lorenzpammer/olfStim/Documentation/LASOMMaterial/LASOM1/Doc/LASOM_Connectors2.jpg

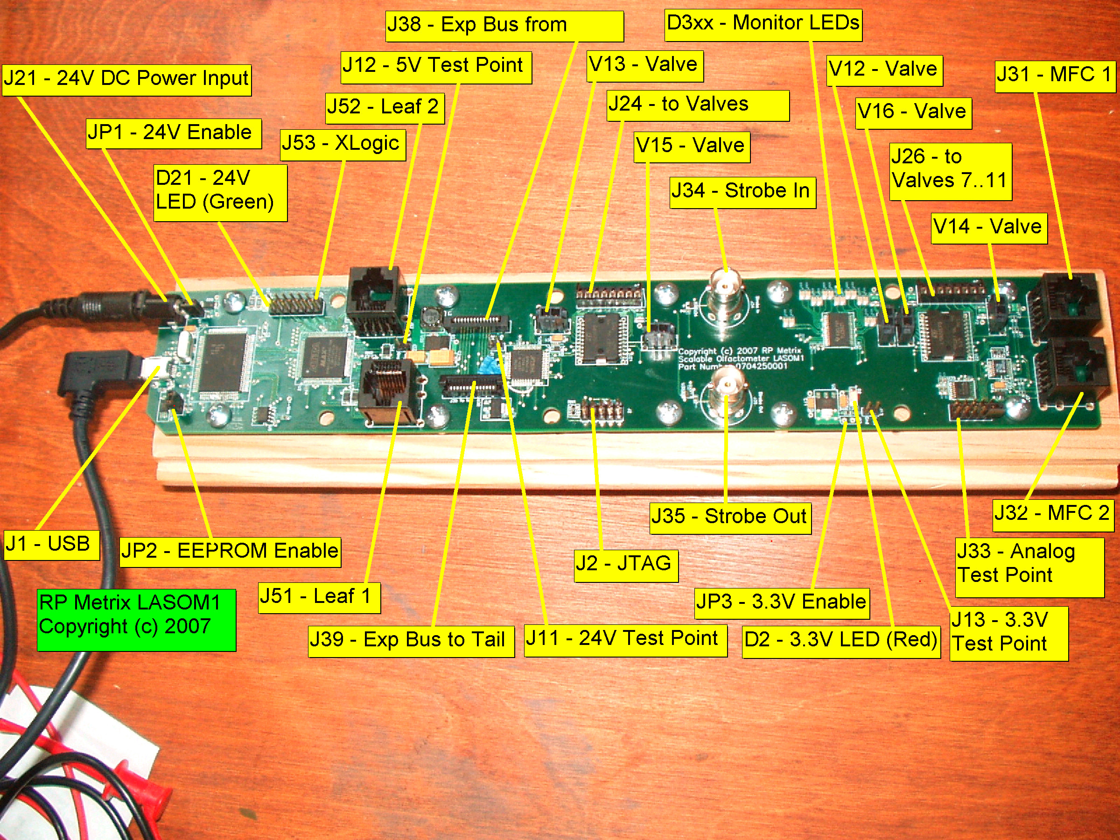
Documentation/LASOMMaterial/LASOM1/Doc/LASOM_Connectors2.jpg
