lorenzpammer/olfStim/Documentation/Hardware Parts/OdorantVials.jpg

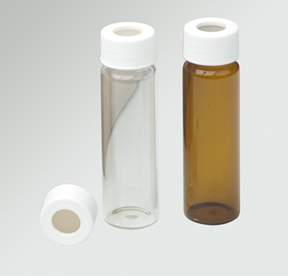
Documentation/Hardware Parts/OdorantVials.jpg
