lorenzpammer/olfStim/README.md

olfStim
=======
olfStim is a collection of functions to control an olfactometer from a gui.
It works but is still very much geared towards use in our lab.
