lorenzpammer/olfStim/Documentation/systemArchitecture.pdf

Master Computer

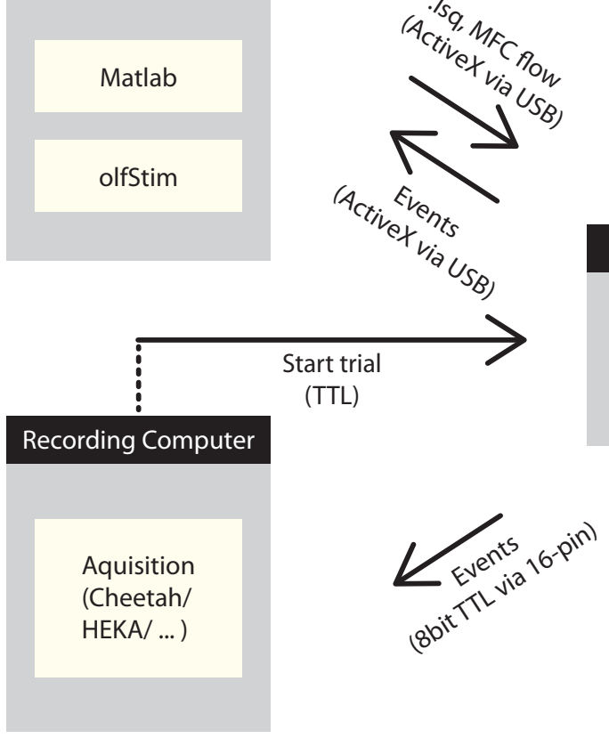
[picture p3: figure]
olfStim; Recording Computer; Aquisition (Cheetah/ HEKA/ ... ); Start trial (TTL); (ActiveX via USB); Events; (8bit TTL via 16-pin); (ActiveX via USB) Events

Matlab

2 MFCs

LASOM C1

LASOM

LASOM V1

Opening/closing
(20 pin connector)

.lsq, MFC ow

≤ 32 valves

Flow rates, etc.
(RS232 via RJ45)
Hardware | Software | Computer

Data ow
(Connector)

Legend

Flow rates, etc.
(RS232 via RJ45)
