lorenzpammer/olfStim/Documentation/Olfactometer_Schematic.jpg

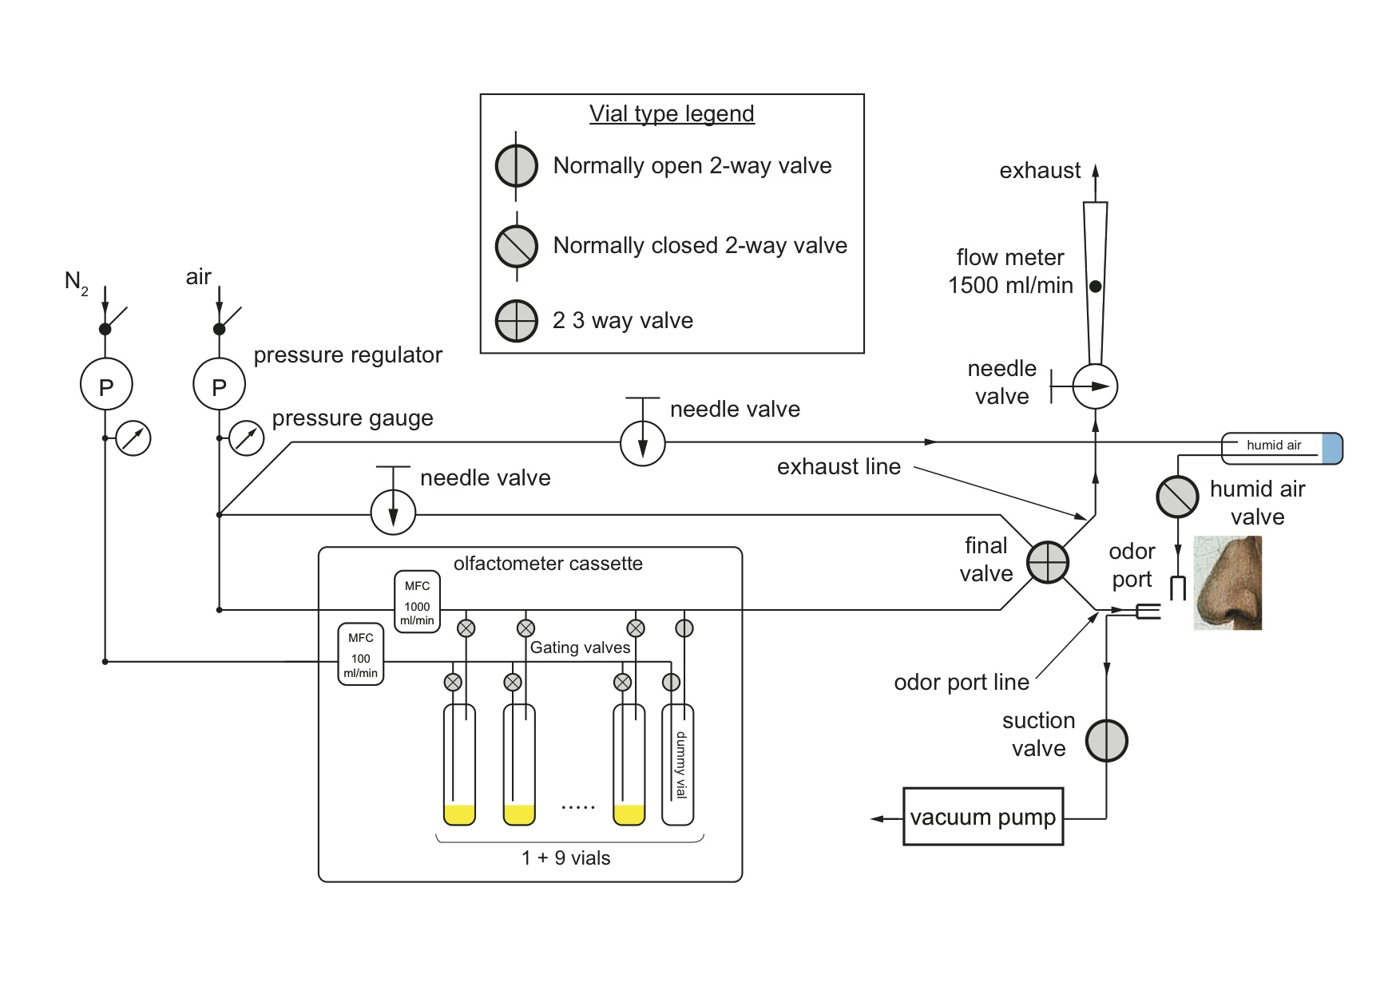
Documentation/Olfactometer_Schematic.jpg
