lorenzpammer/olfStim/Documentation/LASOMMaterial/LASOM2_1102250002/Doc/LASOM2_V1.pdf

LASOM2 Valve Driver Module | LASOM2.V1

## Valve Driver Module for a

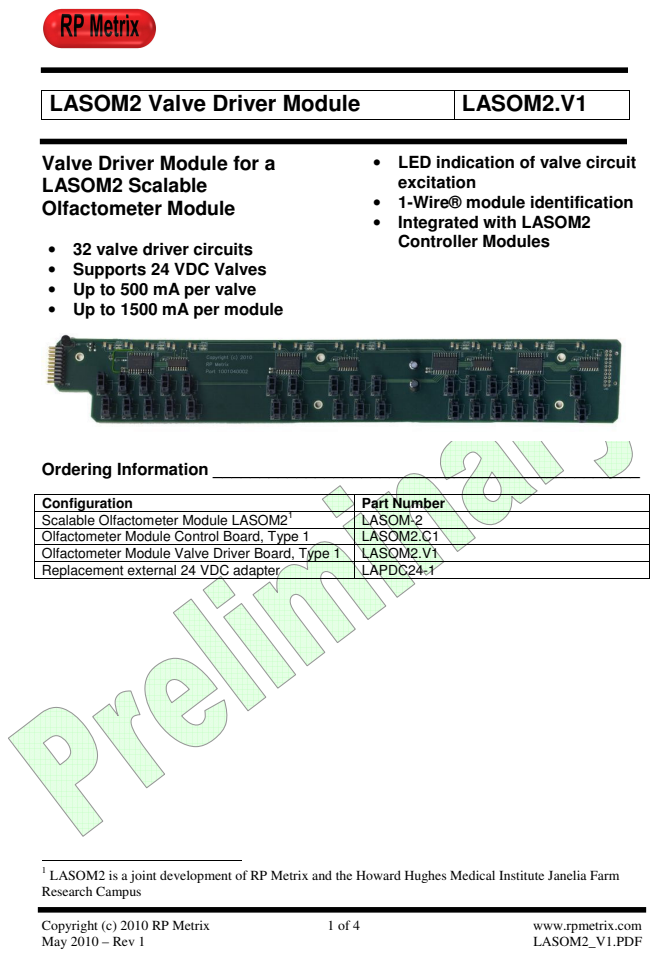
[picture p18: page 1]
Copyright (c) 2010 RP Metrix; www.rpmetrix.com; May 2010 – Rev 1; LASOM2_V1.PDF; LASOM2 Scalable Olfactometer Module; Ordering Information ______________________________________________

• LED indication of valve circuit
excitation
• 1-Wire® module identification
• Integrated with LASOM2
Controller Modules

• 32 valve driver circuits
• Supports 24 VDC Valves
• Up to 500 mA per valve
• Up to 1500 mA per module

Configuration | Part Number
Scalable Olfactometer Module LASOM2¹ | LASOM-2
Olfactometer Module Control Board, Type 1 | LASOM2.C1
Olfactometer Module Valve Driver Board, Type 1 | LASOM2.V1
Replacement external 24 VDC adapter | LAPDC24-1

LASOM2 is a joint development of RP Metrix and the Howard Hughes Medical Institute Janelia Farm
Research Campus

## RP Metrix ____________________________ LASOM2.V1

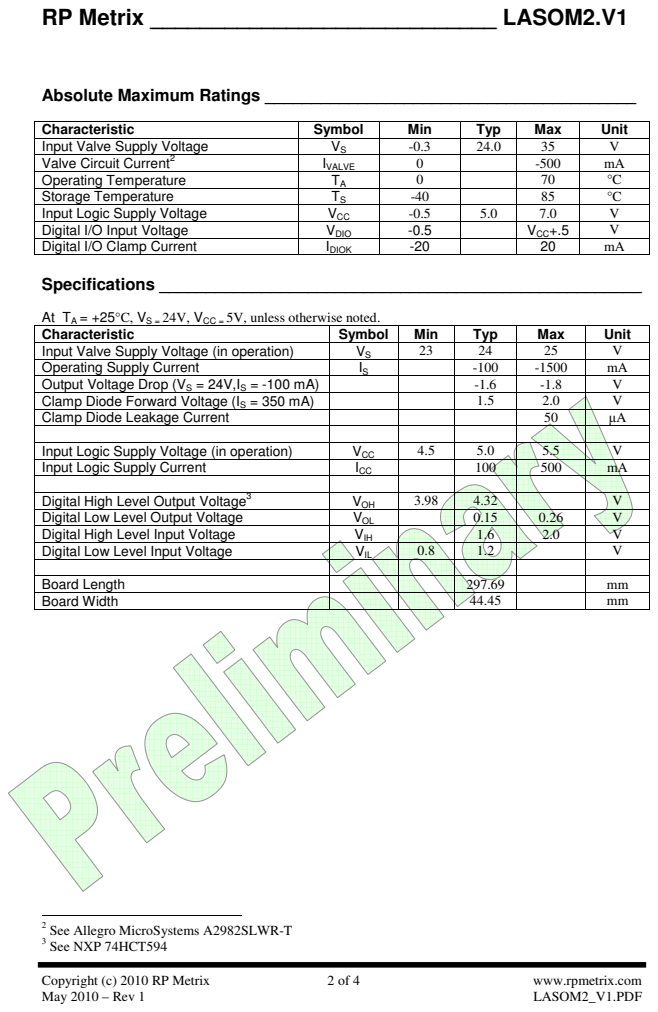
[picture p19: page 2]
Copyright (c) 2010 RP Metrix; www.rpmetrix.com; Specifications ____________________________________________________; See Allegro MicroSystems A2982SLWR-T; See NXP 74HCT594

Absolute Maximum Ratings ________________________________________

Characteristic | Symbol | Min | Typ | Max | Unit
Input Valve Supply Voltage | VS | -0.3 | 24.0 | 35 | V
Valve Circuit Current² | IVALVE | 0 | | -500 | mA
Operating Temperature | TA | 0 | | 70 | °C
Storage Temperature | TS | -40 | | 85 | °C
Input Logic Supply Voltage | VCC | -0.5 | 5.0 | 7.0 | V
Digital I/O Input Voltage | VDIO | -0.5 | | VCC+.5 | V
Digital I/O Clamp Current | IDIOK | -20 | | 20 | mA

At TA = +25°C, VS = 24V, VCC = 5V, unless otherwise noted.

Input Valve Supply Voltage (in operation) | VS | 23 | 24 | 25 | V
Operating Supply Current | IS | | -100 | -1500 | mA
Output Voltage Drop (VS = 24V,IS = -100 mA) | | | -1.6 | -1.8 | V
Clamp Diode Forward Voltage (IS = 350 mA) | | | 1.5 | 2.0 | V
Clamp Diode Leakage Current | | | | 50 | µA

Input Logic Supply Voltage (in operation) | VCC | 4.5 | 5.0 | 5.5 | V
Input Logic Supply Current | ICC | | 100 | 500 | mA

Digital High Level Output Voltage³ | VOH | 3.98 | 4.32 | | V
Digital Low Level Output Voltage | VOL | | 0.15 | 0.26 | V
Digital High Level Input Voltage | VIH | | 1.6 | 2.0 | V
Digital Low Level Input Voltage | VIL | 0.8 | 1.2 | | V

Board Length | 297.69 | mm
Board Width | 44.45 | mm

Copyright (c) 2010 RP Metrix | 3 of 4 | www.rpmetrix.com

### Description ______________________________________________________

The LASOM2 Scalable Olfactometer Module is a plug mount module that connects to clean gas sources and delivers an odorized gas flow to an olfaction experiment. See the LASOM2.C1 datasheet for a more detailed description.

The LASOM2.V1 Valve Driver Module converts logic level control signals into valve excitation signals for up to 32 valves using 24 VDC drive coils. A LASOM2.Cx Controller Module prepares the control signals and directs the valve driver module to energize the valves.

The core logic components on the Valve Driver Module comprise a daisy chain of four 74HCT594 8-bit shift registers. The Controller Module shifts a 32-bit word of excitation signals into the register chain, and then copies the result into the 74HCT594 output registers.

Each of the 32 register output logic signals drives a monitor LED (D401..D432) and energizes a high-side 24VDC valve driver. The drivers are internally protected from short circuits and thermal overload. The per-valve current capacity of 500 mA is far above the typical 10 to 20 mA requirement of odor selection valve coils.

The LASOM2.V1 Driver Module is intended to support an olfactometer servicing 10 to 14 odor vials, with 2 valve circuits used per vial. One extra vial is typically operated with normally open valves to support a background gas flow comparable to the flow occurring when an actual odor is selected. This implies that up to 15 vials and 30 valve circuits are committed to odor selection, with 2 valve circuits unassigned. Controller Module firmware manages these conventions for valve circuit activation – the Valve Driver itself merely carries out instructions to energize an arbitrary combination of 32 valve circuits.

The previous 32-bit control word is normally looped back to the Controller via resistor R40. The J40 expansion port may be used to extend the valve driver to additional valves. (Appropriate controller firmware modifications are also required.)

The on board 1-Wire Identifier chip electronically serializes the Driver Module so that the set of odor vials coupled to the board can be tracked in managed between experiments.

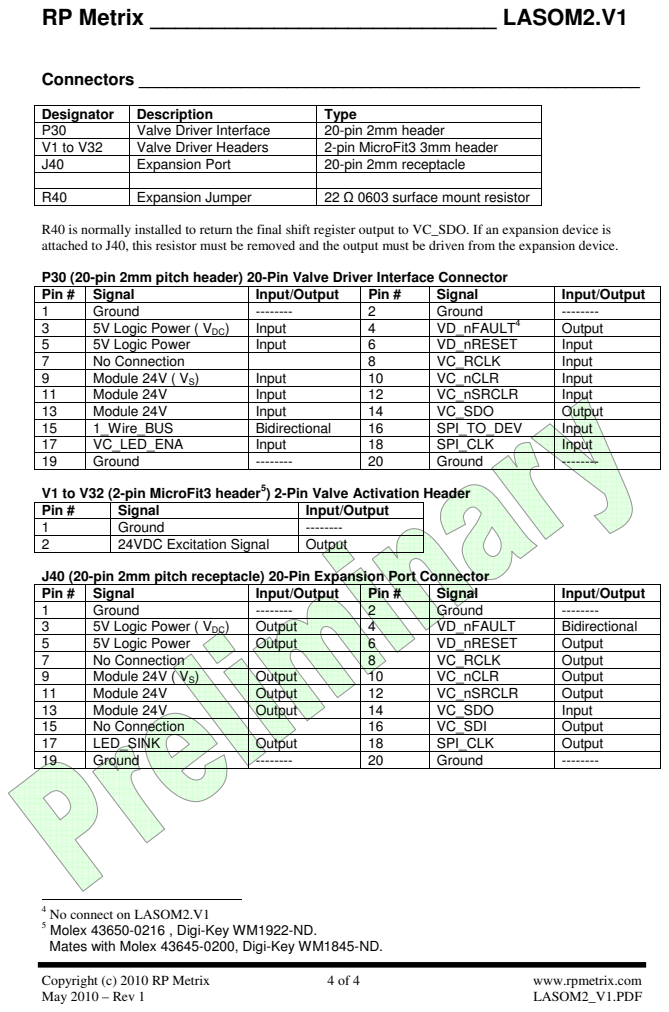
[picture p20: page 4]
Copyright (c) 2010 RP Metrix; www.rpmetrix.com; Connectors ______________________________________________________; Expansion Jumper; 22 Ω 0603 surface mount resistor

Designator | Description | Type
P30 | Valve Driver Interface | 20-pin 2mm header
V1 to V32 | Valve Driver Headers | 2-pin MicroFit3 3mm header
J40 | Expansion Port | 20-pin 2mm receptacle

R40 is normally installed to return the final shift register output to VC_SDO. If an expansion device is
attached to J40, this resistor must be removed and the output must be driven from the expansion device.

P30 (20-pin 2mm pitch header) 20-Pin Valve Driver Interface Connector

Pin # | Signal | Input/Output | Pin # | Signal | Input/Output
1 | Ground | -------- | 2 | Ground | --------
3 | 5V Logic Power ( VDC) | Input | 4 | VD_nFAULT⁴ | Output
5 | 5V Logic Power | Input | 6 | VD_nRESET | Input
7 | No Connection | | 8 | VC_RCLK | Input
9 | Module 24V ( VS) | Input | 10 | VC_nCLR | Input
11 | Module 24V | Input | 12 | VC_nSRCLR | Input
13 | Module 24V | Input | 14 | VC_SDO | Output
15 | 1_Wire_BUS | Bidirectional | 16 | SPI_TO_DEV | Input
17 | VC_LED_ENA | Input | 18 | SPI_CLK | Input
19 | Ground | -------- | 20 | Ground | --------

V1 to V32 (2-pin MicroFit3 header⁵

) 2-Pin Valve Activation Header

Pin # | Signal | Input/Output
1 | Ground | --------
2 | 24VDC Excitation Signal | Output

J40 (20-pin 2mm pitch receptacle) 20-Pin Expansion Port Connector

3 | 5V Logic Power ( VDC) | Output | 4 | VD_nFAULT | Bidirectional
5 | 5V Logic Power | Output | 6 | VD_nRESET | Output
7 | No Connection | | 8 | VC_RCLK | Output
9 | Module 24V ( VS) | Output | 10 | VC_nCLR | Output
11 | Module 24V | Output | 12 | VC_nSRCLR | Output
13 | Module 24V | Output | 14 | VC_SDO | Input
15 | No Connection | | 16 | VC_SDI | Output
17 | LED_SINK | Output | 18 | SPI_CLK | Output

No connect on LASOM2.V1
Molex 43650-0216 , Digi-Key WM1922-ND.
Mates with Molex 43645-0200, Digi-Key WM1845-ND.
