lorenzpammer/olfStim/Documentation/Hardware Parts/Ordering Info/Olfactometer Parts.xls

Vendor | Part Number | Description | Quantity | Units | Price each | Price | Currency | Comment
Nresearch | TBGM109 | Teflon Tubing OD 1/16, ID 1/32 | 30.00 | ft | 1.49 | 44.70 | $
Nresearch | TBGM108 | Teflon Tubing OD 0.105, ID 1/16 | 20.00 | ft | 1.49 | 29.80 | $
Nresearch | TBGM103 | Silicone Tubing, OD 1/4, ID 1/8 | 10.00 | ft | 3.10 | 31.00 | $
Nresearch | 252P109-50 | Two Piece Fitting Sets 1/4-28 | 1.00 | ea | 161.68 | 161.68 | $ | Fittings for OD 1/16 tubing
Nresearch | 253P108-50 | Three Piece Fitting Sets 1/4-28 | 1.00 | ea | 202.24 | 202.24 | $ | Fittings for OD 0.105 tubing
Nresearch | FITM128 | Plug 1/4-28 | 10.00 | ea | 1.56 | 15.60 | $
Nresearch | FITM131 | 1/4-28 Connectors Straight Teflon | 5.00 | ea | 10.88 | 54.40 | $
Nresearch | FITM132 | 1/4-28 Connectors Elbow Teflon | 3.00 | ea | 10.88 | 32.64 | $
Nresearch | FITM133 | 1/4-28 Connectors Tee Teflon | 5.00 | ea | 13.50 | 67.50 | $
Nresearch | FITM331 | Barb Fitting Zero Dead Volume (1/4-28, 1/16) | 5.00 | ea | 2.42 | 12.10 | $
Nresearch | FITM087 | Standard Barb Fittings, 1/8NPT, 1/16 | 6.00 | ea | 0.50 | 3.00 | $
Nresearch | FITM089 | Standard Barb Fittings, 1/8NPT, 1/8 | 4.00 | ea | 0.50 | 2.00 | $
Nresearch | MCRM360 | Mounting Rings for 360 valves | 4.00 | ea | 11.46 | 45.84 | $
Nresearch | SH360T042 | Dual 3-way isolation valve, 4 ports, 24V | 1.00 | ea | 162.69 | 162.69 | $
Nresearch | 360T012 | Standard 2-way normally closed valve, 2mm orifice, teflon-teflon, 24 V | 3 | ea | 112.53 | 337.59 | $
Nresearch | 360T022 | Standard 2-way Normally Open, 3mm orifice, teflon-teflon, 24 V | 1.00 | ea | 110.93 | 110.93 | $
Nresearch | 161T102HH | Inline 5x2 way (1NO-4NC, 24V) | 2.00 | ea | 323.31 | 646.62 | $
Nresearch | 161T102 | Inline 5x2 way Normally closed, 24V | 2.00 | ea | 323.31 | 646.62 | $
Omnifit (via Novodirect) | 24600 | Omnifit small 2-way straight connector 1.5 mm | 2 | ea | 53.00 € | 106.00 | €
Omnifit (via Novodirect) | 24400 | Omnifit small 2-way straight connector 0.8 mm | 3 | ea | 60.80 € | 182.40 | €
Omnifit (via Novodirect) | 24750 | Omnifit small 2-way L-connector 1.5 mm | 1 | ea | 60.50 € | 60.50 | €
Omnifit (via Novodirect) | 24606 | Omnifit small 3-way T connector 1.5 mm | 3 | ea | 57.70 € | 173.10 | €
Omnifit (via Novodirect) | 24607 | Omnifit large to small connector 1.5 mm diam | 1 | ea | 73.10 € | 73.10 | €
Omnifit (via Novodirect) | 24608 | Omnifit large 2 way connector 4.5 mm diam | 1 | ea | 86.20 € | 86.20 | €
Omnifit (via Novodirect) | 24672 | Omnifit O-Ring 0.5-4 mm for small OD | 2 | ea | 6.30 € | 12.60 | €
Omnifit (via Novodirect) | 24673 | Omnifit O-Ring 0.5-4 mm for large OD | 2 | ea | 6.30 € | 12.60 | €
Omnifit (via Novodirect) | 24641 | Omnifit PTFE cone 3 mm | 1 | ea | 14.50 € | 14.50 | €
Omnifit (via Novodirect) | 24639 | Omnifit PTFE cone 2 mm | 1 | ea | 14.50 € | 14.50 | €
Omnifit (via Novodirect) | 24632 | Omnifit PTFE cone1/16" | 1 | ea | 14.50 € | 14.50 | €
Aalborg (via Novodirect) | W728AC | Aalborg Needle Valve PTFE 1/8NPT HighRes | 2.00 | ea | 164.00 | 328.00 | €
Aalborg (via Novodirect) | W73344 | Aalborg Flow Meter tube Air 23l/min 15cm | 1.00 | ea | 95.00 | 95.00 | €
