lorenzpammer/olfStim/Documentation/Hardware Parts/ColumnClamp.jpg

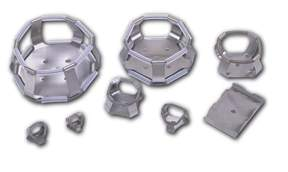
Documentation/Hardware Parts/ColumnClamp.jpg
