lorenzpammer/olfStim/Documentation/Hardware Parts/GasFilterColumn.jpg

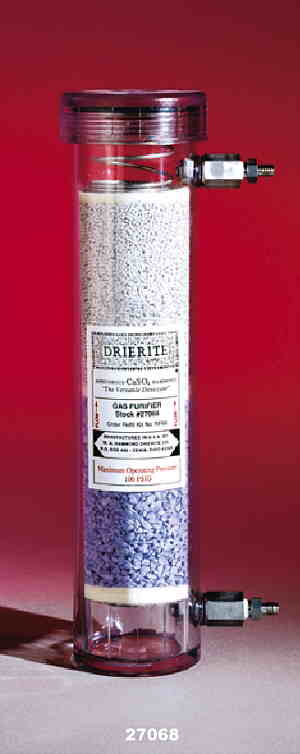
Documentation/Hardware Parts/GasFilterColumn.jpg
