lorenzpammer/olfStim/Documentation/Hardware Parts/Custom Machining/3D Printing Valve Holders/V1/HolderNResearch648Series.SLDPRT

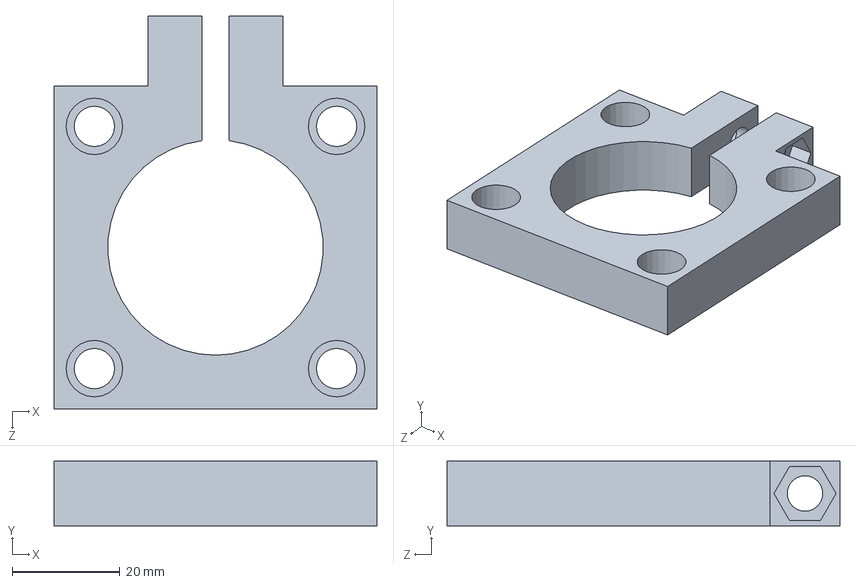
[picture p24: CAD file, 2015-01-07]
Documentation/Hardware Parts/Custom Machining/3D Printing Valve Holders/V1/HolderNResearch648Series.SLDPRT
60.0 x 12.0 x 73.0 mm
