lorenzpammer/olfStim/Documentation/Hardware Parts/Custom Machining/3d Printing Vial Holders/Holder_OdorVialsV3.SLDPRT

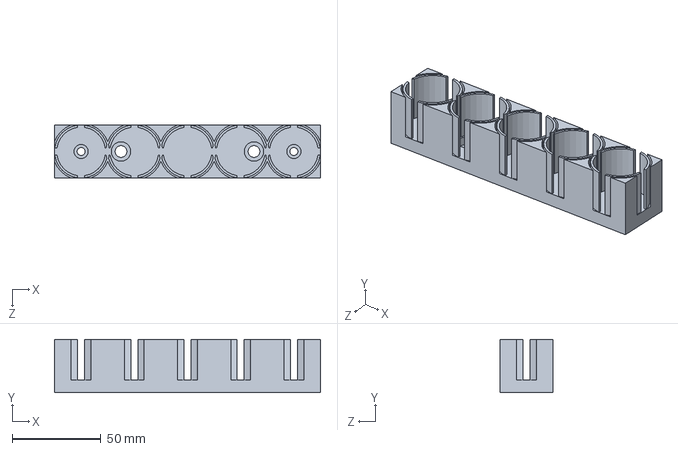
[picture p25: CAD file, 2015-01-07]
Documentation/Hardware Parts/Custom Machining/3d Printing Vial Holders/Holder_OdorVialsV3.SLDPRT
150.0 x 30.0 x 30.0 mm
