lorenzpammer/olfStim/Documentation/Hardware Parts/Custom Machining/3d Printing Vial Holders/v2/Holder_OdorVialsV2.SLDPRT

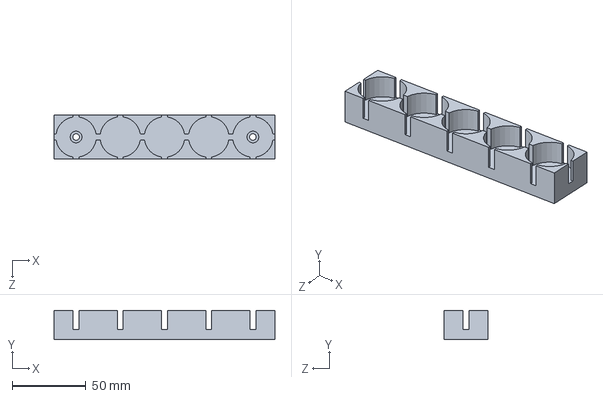
[picture p26: CAD file, 2015-01-07]
Documentation/Hardware Parts/Custom Machining/3d Printing Vial Holders/v2/Holder_OdorVialsV2.SLDPRT
150.0 x 20.0 x 30.0 mm
