lorenzpammer/olfStim/Documentation/Hardware Parts/Custom Machining/3D Printing Valve Holders/HolderNResearch648Seriesv2.SLDPRT

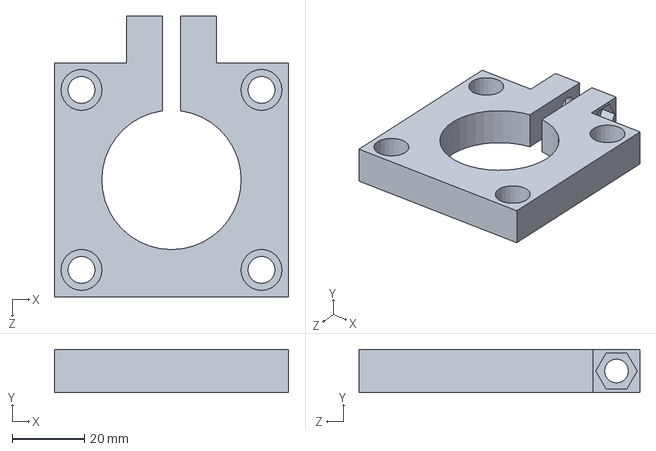
[picture p27: CAD file, 2015-01-07]
Documentation/Hardware Parts/Custom Machining/3D Printing Valve Holders/HolderNResearch648Seriesv2.SLDPRT
65.0 x 12.0 x 78.0 mm
