lorenzpammer/olfStim/Documentation/Hardware Parts/Custom Machining/3d Printing Vial Holders/Holder_OdorVialsV3_3Vials.SLDPRT

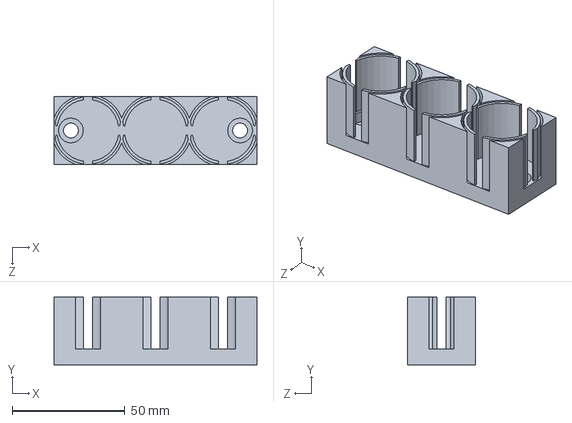
[picture p28: CAD file, 2015-01-07]
Documentation/Hardware Parts/Custom Machining/3d Printing Vial Holders/Holder_OdorVialsV3_3Vials.SLDPRT
90.0 x 30.0 x 30.0 mm
