lorenzpammer/olfStim/Documentation/Hardware Parts/Custom Machining/3D Printing Valve Holders/V1/HolderNResearch225Series.STL

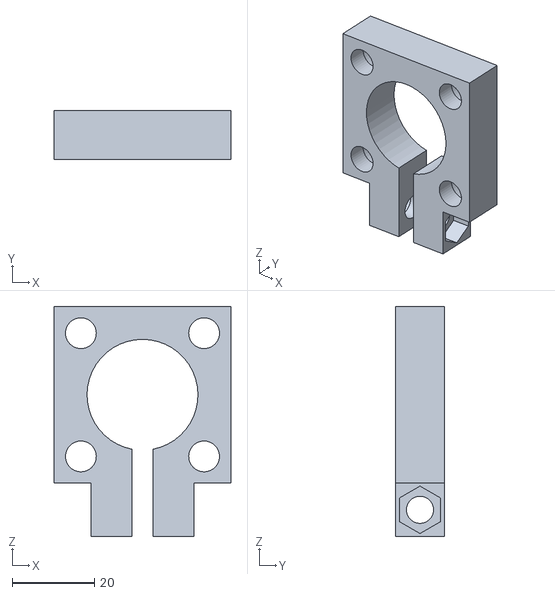
[picture p29: CAD file, 2015-01-07]
Documentation/Hardware Parts/Custom Machining/3D Printing Valve Holders/V1/HolderNResearch225Series.STL
43.0 x 12.0 x 56.0
