lorenzpammer/olfStim/Documentation/Hardware Parts/Custom Machining/3d Printing Vial Holders/v1/Holder_OdorVials.SLDPRT

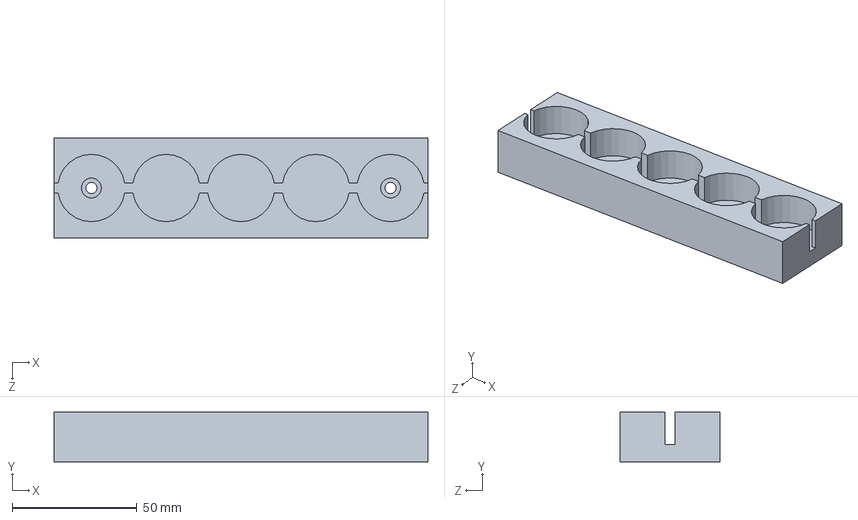
[picture p30: CAD file, 2015-01-07, an earlier design]
Documentation/Hardware Parts/Custom Machining/3d Printing Vial Holders/v1/Holder_OdorVials.SLDPRT
150.0 x 20.0 x 40.0 mm
