lorenzpammer/olfStim/(list of files, cad)

Other CAD files:
Documentation/Hardware Parts/Custom Machining/3D Printing Valve Holders/V1/HolderNResearch360Series.STL
Documentation/Hardware Parts/Custom Machining/3D Printing Valve Holders/HolderNResearch225Seriesv2.SLDPRT
Documentation/Hardware Parts/Custom Machining/3D Printing Valve Holders/HolderNResearch225Seriesv2.STL
Documentation/Hardware Parts/Custom Machining/3D Printing Valve Holders/HolderNResearch360Seriesv2.STL
Documentation/Hardware Parts/Custom Machining/3D Printing Valve Holders/HolderNResearch648Seriesv2.STL
Documentation/Hardware Parts/Custom Machining/3d Printing Vial Holders/Holder_OdorVialsV3.STL
Documentation/Hardware Parts/Custom Machining/3d Printing Vial Holders/Holder_OdorVialsV3_3Vials.STL
Documentation/Hardware Parts/Custom Machining/3d Printing Vial Holders/v1/Holder_OdorVials.SLDDRW
Documentation/Hardware Parts/Custom Machining/3d Printing Vial Holders/v1/Holder_OdorVials.STL
Documentation/Hardware Parts/Custom Machining/3d Printing Vial Holders/v2/Holder_OdorVialsV2.STL
