lorenzpammer/olfStim/Documentation/LASOMMaterial/LASOM1/Doc/Leaf_Wiring.pdf

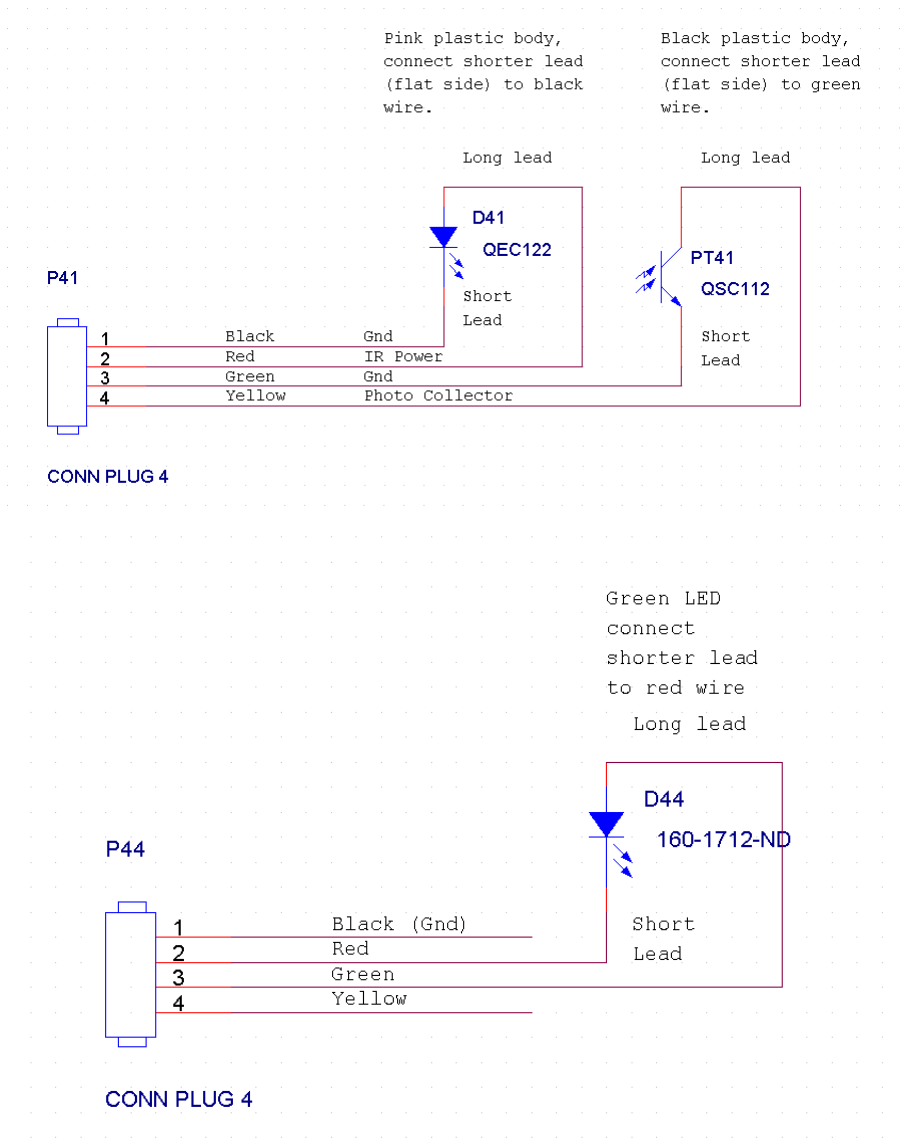
[picture p31: figure]
