lorenzpammer/olfStim/Documentation/Olfactometer_Schematic_General.pdf

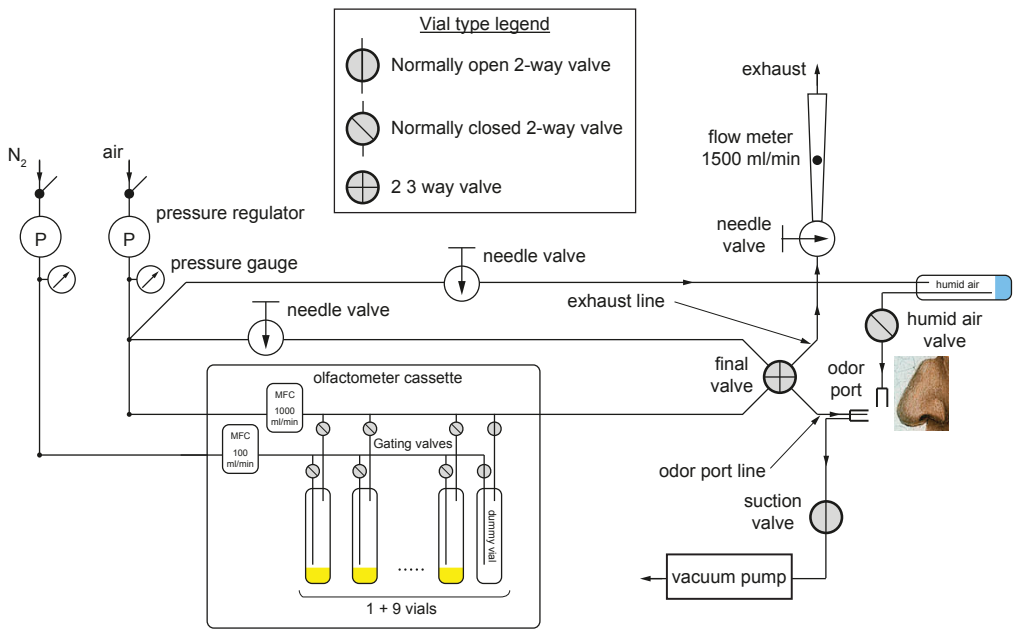
[picture p32: page 1]
air; final valve; exhaust; odor port; flow meter 1500 ml/min; pressure regulator; pressure gauge; needle valve; exhaust line; MFC 100 ml/min; MFC 1000 ml/min; 1 + 9 vials; olfactometer cassette; dummy vial; Gating valves; suction valve; humid air humid air valve; needle; vacuum pump; 2 3 way valve

Vial type legend
Normally open 2-way valve

Normally closed 2-way valve

valve needle valve

odor port line
