lorenzpammer/olfStim/Documentation/Olfactometer_Schematic_LaurentLab.pdf

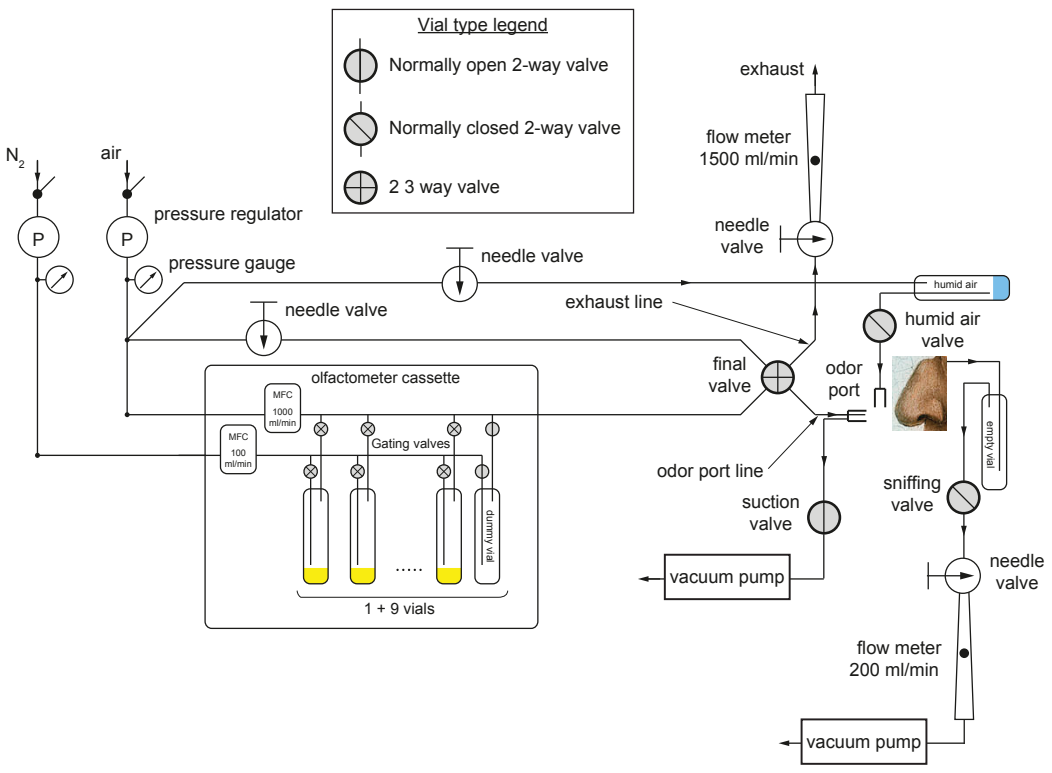
[picture p33: page 1]
air; final valve; exhaust; odor port; flow meter 1500 ml/min; pressure regulator; pressure gauge; needle valve; exhaust line; MFC 100 ml/min; MFC 1000 ml/min; 1 + 9 vials; olfactometer cassette; dummy vial; Gating valves; suction valve; humid air humid air valve; sniffing valve; flow meter 200 ml/min; vacuum pump; needle; 2 3 way valve; empty vial

Vial type legend
Normally open 2-way valve

Normally closed 2-way valve

valve needle valve

odor port line
