lorenzpammer/olfStim/Documentation/OlfactometerCassette.pdf

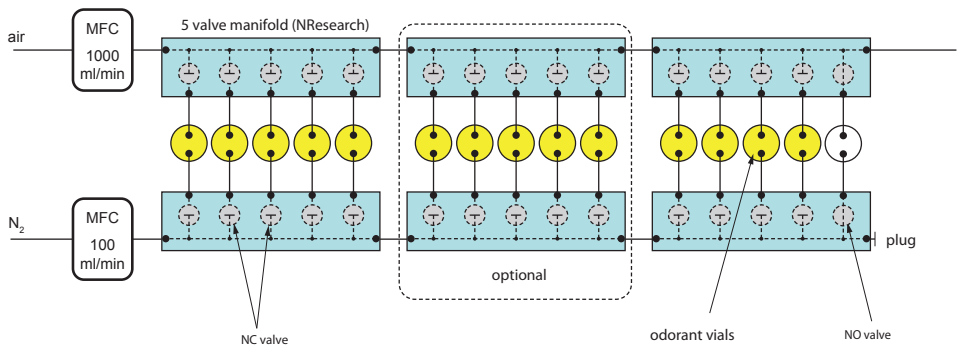
[picture p34: page 1]
air; MFC 1000 ml/min; MFC 100 ml/min; optional; odorant vials; plug

5 valve manifold (NResearch)

NO valve NC valve
