lorenzpammer/olfStim/Documentation/Hardware Parts/Custom Machining/AluminumBlockForMFCIQFlow.pdf

## UNF 10- 32 UNF 10- 32

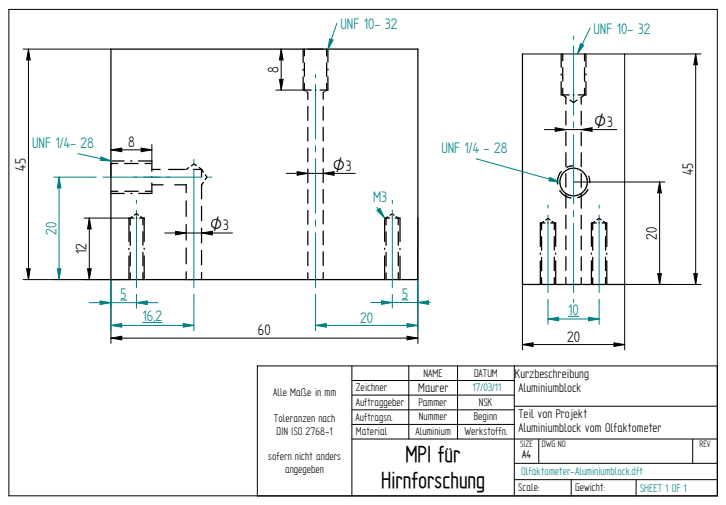
[picture p35: page 1]
Scale:; Gewicht:; SHEET 1 OF 1; UNF 1/4- 28; UNF 1/4 - 28

Alle Maße in mm Toleranzen nach DIN ISO 2768-1 sofern nicht anders angegeben | | NAME | DATUM | Kurzbeschreibung Aluminiumblock

Zeichner | Maurer | 17/03/11
Auftraggeber | Pammer | NSK
Auftragsn. | Nummer | Beginn
Material | Aluminium | Werkstoffn.
MPI für Hirnforschung | SIZE A4 | DWG NO | REV

Teil von Projekt
Aluminiumblock vom Olfaktometer

Olfaktometer-Aluminiumblock.dft
