lorenzpammer/olfStim/Documentation/Hardware Parts/Custom Machining/3d Printing Vial Holders/Olfaktometer-VialHolder.pdf

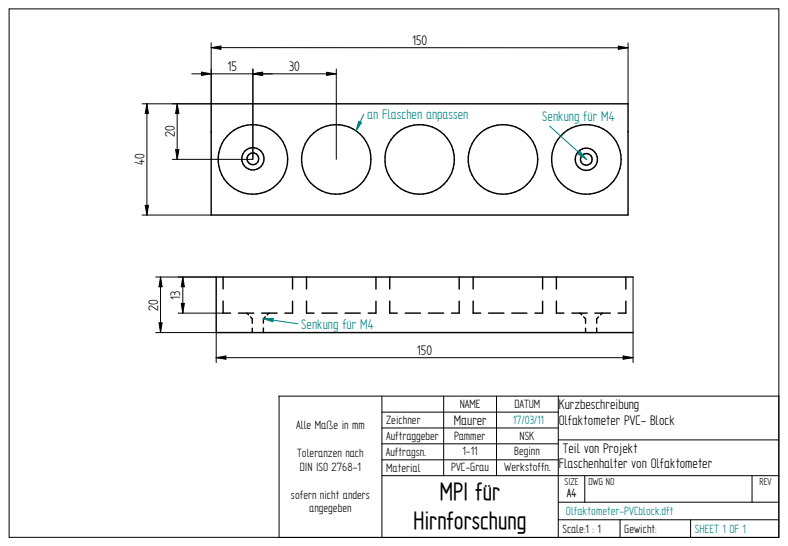
[picture p36: page 1]
Scale:1 : 1; Gewicht:; SHEET 1 OF 1; an Flaschen anpassen; Senkung für M4

Alle Maße in mm Toleranzen nach DIN ISO 2768-1 sofern nicht anders angegeben | | NAME | DATUM | Kurzbeschreibung Olfaktometer PVC- Block

Zeichner | Maurer | 17/03/11
Auftraggeber | Pammer | NSK
Auftragsn. | 1-11 | Beginn
Material | PVC-Grau | Werkstoffn.
MPI für Hirnforschung | SIZE A4 | DWG NO | REV

Teil von Projekt
Flaschenhalter von Olfaktometer

Olfaktometer-PVCblock.dft
