lorenzpammer/olfStim/(commit log)

2011-10-24 Admitting a version that should get rid of case-folding collision error on windows.
2011-10-24 Committing a version that should get rid of case-folding collision error on windows.
2011-12-12 Couple of changes to the olfStim package
2011-12-16 Created & debugged the cleaning olfactometer protocol (cleanOlfactometerStim). Created the startTrial function (not started coding yet). Adapted the core.lsq file to incorporate general nomenclature 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
2012-07-25 Fixed critical bug in buildSmell (indexing error, which led to errors in trials > 1).
2012-07-26 Quitting the gui now results in a gui prompting the user to save the smell structure. Triggering of every new trial results in saving a temporary smell structure into the new temp folder. The flow ra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
2012-07-27 Fixed a bunch of bugs related to the 'used' setting of the different olfactometer instructions. The resulting lsq file will now lack the commands for triggering valves which have been unchecked for u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
2012-07-30 olfStim now includes control for the humidity valve. Fixed bug in buildTrialLsq, that no timestamp is sent for the first action. Fixed bug relating to wait times before triggering the next step in th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
2012-07-31 Changed order of olfactometer instructions. Now opening a valve is always followed by closing it.
2012-08-05 Trial sequence figure can now handle multiple opening & closing times for different valves, if this is defined as a vector [x y] in the olfactometerInstructions panel.
2012-08-05 Updated buildTrialLsq. olfStim can now handle multiple opening/closing actions for each valve in the course of one trial.
2012-08-10 Fixed critical bug in the calculation of MFC flow rates. Now it should do it correctly.
2012-08-10 Fixed critical bug in the buildTrialLsq, which led under some circumstances to an absence of the timer command.
2012-08-15 Hacked lsq files, buildTrialLsq.m and timeStampDefinitions.m in a way that timestamps will be sent for the gating valves, final valve, sniffing valve and suction valve. OUtput will be via the XLogicO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
2012-08-15 olfStim now checks the following: once the user enters values into the concentration edit fields and mfcTotalFlow fields, callback functions check whether the values can be achieved given the maximum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
2012-08-16 Mass flow controller flow rates are now measured every 100ms during a trial, and the results are stored in the smell structure. smell.trial(i).lasomEventLog.flowRateMfcX. The olfactometer is now purg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
2012-08-17 olfStim now reads the statuses emitted by the olfactometer every ms to detect trial start. Once trial started it reads the statuses every 100 ms to detect the sequencer going idle. Once the sequencer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
2012-08-17 Debugging the timers, that control measuring MFC flow rates, purging and checking the emitted statuses.
2012-08-17 Debugged, startTrial.m still makes problems with the timers.
2012-08-27 Concentration edit fields in the manualStim and manualSessionProgrammingStim protocols will now be set up with the maximum possible concentration value, given the dilution of the odorant, the flow ra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
2012-08-27 The figure to show the sequence of the trial can now be closed, by clicking the close button on the figure or clicking the trialSeq button in the main gui another time.
2012-08-27 For testing the timers, I added startTrialTesting.m
2012-08-29 In the process of debugging the timers in startTrial. Made some progress. Not done yet.
2012-08-30 Continued to debug the timers for starTrial.m Making progress, not done yet.
2012-09-04 Still debugging the timers in startTrial.m One remaining problem: checking whether mfc flow measuring timer is done.
2012-09-04 The timepoint of purging can not be set by the user anymore. Rather if the user chooses the purge option, the Mfcs will be set to 100% once the sequencer has finished executing the code. The Mfc flow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
2012-09-07 Fixed more bugs with the timer. Now the startTrial.m function should remain active until the sequencer is done executing. If LASOM shows the strange error #205 behavior, the error should be caught. I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
2012-09-11 A couple of bug fixes relating to the sessionSettings. Also manualStim now uses the sessionSettings.
2012-09-12 Changed layout of gui. Quit and save is on the left side. If used Start session and End session are on the right. Once start session is pushed, in manualSessionProgrammingStim, one can pause the exec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
2012-09-12 If the user ends a manualSessionProgrammingStim session before it is finished executing all instructed trials (number of trials in smell), the program will now delete the non-executed trials from the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
2012-09-17 A couple of changes being connected to the olfactometer.
2012-09-18 New button allowing user to clear all data associated with a session, and start again (Smell is deleted, and set up again) Closes #3
2012-09-21 Critical Bug Fix for several actions of one valve
    Fixes bug, which broke the feature of opening and closing one valve
    multiple times within a trial.
2012-09-26 lasomH is now written into appdata ofthe gui. Allows startTrial to check if connection to LASOM was closed properly in the last trial, and close it in case something went wrong. Prevents opening mult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
2012-09-26 Mfc flow rates are now written to the smell structure. Changed variable scope.
2012-10-31 Current odor is output to matlab command window. Fixes #16. If no inter trial interval period is defined, it defaults to an inter trial interval of 0 seconds. Fixes #10.
2012-11-02 Sequencer sometimes doesn't terminate - ie the sequencer status remains at 1. This caused the timers in startTrial.m to fail to terminate. Now only relying on the variable we're setting. It's a hack.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
2012-12-07 Fixes #22. Olfactometer is now queried to get the maximum MFC flow rates. These are written to smell (smell.olfactometerSettings.slave(i).maxFlowRateMfcX) and all downstream functions should now use 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
    q
2013-01-07 Working on issue #27. Added I/O button to sessionSettings panel.
2013-03-07 Fixed two bugs, giving errors when changing the total flow rate and startTrial didn't transmit the errorType as an argument to calculateMfcFlowRates.m
2013-03-08 Closes #27 and closes #35. Session settings now includes the possibility to set I/O actions. Clicking the I/O button will open a new gui where I/O actions can be selected and the timing defined. An I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
2013-03-13 Fixed a bug in buildTrialLsq.m. If one sets bof in a lsq building block, the sequence timer initiation will be set at this point. This allows things like adding a waiting loop at the beginning of a t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
2013-03-19 Closes #40. Pressing clear button will now clear the log window. Also fixed a bug introduced with the adding of the timestamp.
2013-03-24 Units of session settings are displayed in brackets in the gui.
2013-03-26 Closes #43 and closes #44. There's a general configuration file found in configuration/configuration.m. Valve names and times can now be set in this configuration file. Cleaned repo.
2013-03-26 Fixed critical bug, ug, relating to adding new valve actions with different names.
2013-03-26 Forgot to change the valve names back to our normal ones.
2013-03-27 Closes #46 and closes #47 . When notes are extracted they are sent to the log window, and therefore also present in the log field in the smell structure. Changed the file structure of the notes funct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
2013-04-11 Adapted the lsq files to be more consistent with the new way of organizing valve actions. Connector indices have to be written as numbers for each action. No variables anymore.
2013-07-31 Factored out the creation of push buttons and edit fields for every odorant in the manualSessionProgrammingStim stimulation protocol.
2013-07-31 Fixed bug, relating to the incorrect arrangement of odorant push buttons, when some vial positions are not filled, and if different number of vials are loaded in multiple slaves.
2013-08-01 manualSessionProgrammingStim should now be able to handle multiple slaves attached to the master LASOM controller. Up to 100 different odorants can now be loaded in the olfactometer. This functionali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
2013-08-01 Closes #7. manualStim now also supports presenting odorants from multiple LASOM slaves. The last commits close the issue. Still has to be tested with an actual olfactometer attached.
2015-01-07 Closes #75. Added 3D CAD designs for 3D printing olfactometer parts such as holders for valves and vials. But also the design for the aluminum block, which has to be attached to the Bronkhorst IQ flo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
    [HolderNResearch225Series.STL, HolderNResearch225Seriesv2.SLDPRT, HolderNResearch225Seriesv2.STL, HolderNResearch360Series.STL, HolderNResearch360Seriesv2.SLDPRT, HolderNResearch360Seriesv2.STL, HolderNResearch648Series.SLDPRT, HolderNResearch648Seriesv2.SLDPRT]
2015-01-07 Closes #77. If multiple users are on one machine, each can supply his/her username as an argument to initOlfStim, upon which their personal configuration file will be loaded and their name will also 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
    [Holder_OdorVials.SLDDRW, Holder_OdorVials.SLDPRT, Holder_OdorVials.STL, Holder_OdorVialsV2.SLDPRT, Holder_OdorVialsV2.STL, Holder_OdorVialsV3.SLDPRT, Holder_OdorVialsV3.STL, Holder_OdorVialsV3_3Vials.SLDPRT]
2015-02-04 Added I/O actions to set digital out lines high and low.
    [Holder_OdorVials.SLDDRW, Holder_OdorVials.SLDPRT, Holder_OdorVials.STL, Holder_OdorVialsV2.SLDPRT, Holder_OdorVialsV2.STL]
2015-02-09 Expanded documentation, added documenting images, cleaned up the folder structure.
    [HolderNResearch225Series.STL, HolderNResearch225Seriesv2.SLDPRT, HolderNResearch225Seriesv2.STL, HolderNResearch360Series.STL, HolderNResearch360Seriesv2.SLDPRT, HolderNResearch360Seriesv2.STL, HolderNResearch648Series.SLDPRT, HolderNResearch648Seriesv2.SLDPRT]
2015-02-25 Adapted olfactometer access folder, so that it's easier to add new control boards other than LASOM. Updated Documentation.
2015-02-25 A couple of changes to debug the scripting mode.
2015-04-07 Updated colour scheme of valve opening and closing fields.
2015-04-07 Updated Documentation, normally closed 2-way valves were depicted incorrectly.
